Purdue-AM/CerberusVAP/README.md

# CerberusVAP

This repo is for the dual head VAP printer in ZL4 named Cerberus.
