Purdue-AM/CerberusVAP/TransducerConnectors/README.md

Documentation and files (.step and .stl) for transducer connector parts.

A .pdf file with detailed instructions is provided.
