Purdue-AM/CerberusVAP/TransducerConnectors/HW-3H_Conn_MainBody.stl

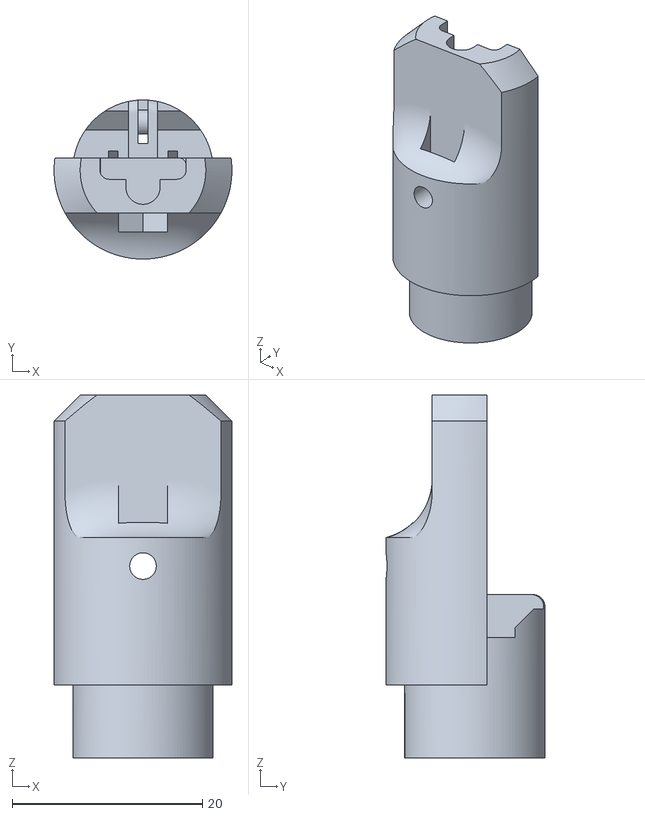
[picture p8: CAD file, 2019-11-10]
TransducerConnectors/HW-3H_Conn_MainBody.stl
18.7 x 16.7 x 38.2
