Purdue-AM/CerberusVAP/TransducerConnectors/VAP_HW-3H_Connector_Assembly_V1.step

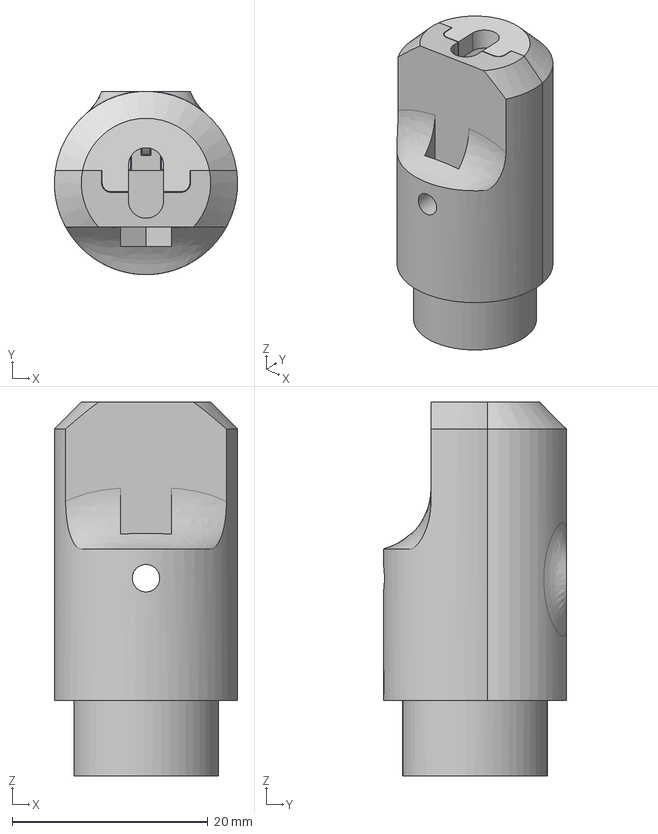
[picture p9: CAD file, 2019-11-10]
TransducerConnectors/VAP_HW-3H_Connector_Assembly_V1.step
18.7 x 18.7 x 38.2 mm
TransducerConnector v3
Cover
bentHeaderPin(outerChannels)
bentHeaderPin(outerChannels) (1)
BentHeaderPin(centerChannel)
