Purdue-AM/CerberusVAP/TransducerConnectors/HW-3H_Conn_TopCover.stl

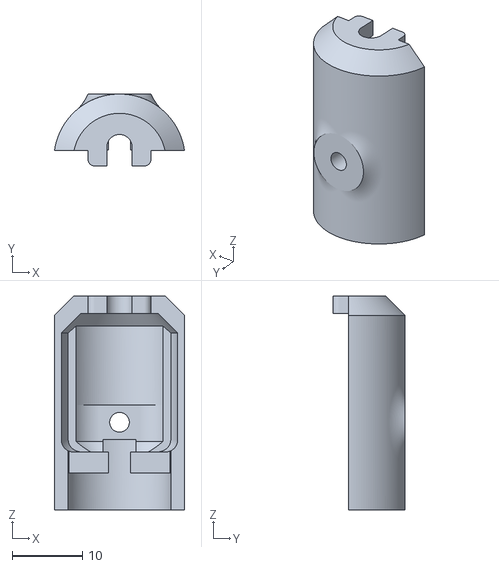
[picture p10: CAD file, 2019-11-10]
TransducerConnectors/HW-3H_Conn_TopCover.stl
18.5 x 10.2 x 30.5
